shenoy10/vlc_repo/BiweeklyStatusReports/Week 1.docx

# BI-WEEKLY STATUS REPORT

Subject: Visual Light Communication
Period Ending: 09/05/2018

ACTIVITIES COMPLETED THIS WEEK

Completed Deliverables:

- Submitted proposal and syllabus to Dr.Julien
- Gathered all original code written for Visible Light Communication on Arduino
- Scavenged list of old, usable VLC hardware from the lab
- Photodiode
- Arduinos (x2)
- Jumper Wires
- Small LED

ACTIVITIES TO BE STARTED NEXT WEEK

- Create list of needed hardware and purchase those new electronics
- Determine the best way to look up light bulb LED
- Find different possible Arduino based circuit schematics

LONG TERM PROJECTS

- Determine whether or not the Arduino is a feasible microcontroller for VLC

Weekly Status Report template Page 2 of 2

Page 1 of 1 Weekly Status Report template
