shenoy10/vlc_repo/BiweeklyStatusReports/Week 13.docx

# BI-WEEKLY STATUS REPORT

Subject: Visual Light Communication
Period Ending: 11/28/2018

ACTIVITIES COMPLETED THIS WEEK

Completed Deliverables:

- Discovered several software issues
- Compiler optimizing out while loop in the transmitter.cpp code
- Synchronization issues with the timer are still a major problem with the device (tried optimizing out the digital write sequence by directly writing to PORTD)
- In the process of building 12volt DC bulb transmitter
- Fritzing diagrams and documenting material

ACTIVITIES TO BE STARTED NEXT WEEK

- Debug final demo

LONG TERM PROJECTS

- Establish “high speed” visible light communication

Week 3 Page 2 of 2

Page 1 of 1 Week 3
