shenoy10/vlc_repo/BiweeklyStatusReports/Week 9.docx

# BI-WEEKLY STATUS REPORT

Subject: Visual Light Communication
Period Ending: 10/31/2018

ACTIVITIES COMPLETED THIS WEEK

Completed Deliverables:

- Completed first draft VLC code based on Manchester Encoding
- Skeleton functions completed for transmitter.cpp and receiver.cpp
- Main functions finished
- There are issues with the interrupt function not running (seems to be a missing library import)
- There are some elaborate compile time involving improper casting of data types
- Purchased DC components from Fry’s electronics
- DC LED lights
- A23 12v battery and holder
- P-type transister

ACTIVITIES TO BE STARTED NEXT WEEK

- Waiting on photodiodes from Amazon
- Construct DC VLC circuit
- Fix dependency issues on Timer1.h
- Add preamble to properly synchronize receiver and transmitter

LONG TERM PROJECTS

- Debug VLC software issues

Week 3 Page 2 of 2

Page 1 of 1 Week 3
