shenoy10/vlc_repo/VLCreceiver.cpp

#include "VLCreceiver.h"

VLCreceiver::VLCreceiver(int pinVal)
{
   this->preamble="123456";
   this->message="";
   this->preambleReceived=false;
   this->voltageSensorPin=pinVal;
   this->numSamples=0;
   this->bitsReceived=0;
}


bool VLCreceiver::checkPreamble(String pream){
  
  return this->preamble==pream;
  
  }
